TampaDeepSeaXplorersOpenSource/Dog-Breath/README.md

# Dog-Breath
High altitude canine respirator
