TampaDeepSeaXplorersOpenSource/Dog-Breath/Parts List for Dog Respirator.odt

Parts List for Dog Respirator

1 x SurgiVet free flow respirator cup

2 x PVC, T coupling, ½” x ¾ “

2 x 1” PVC, end cap, slip fitting

2 x PVC female reducer, ¾” x ½”, npt threaded

1 x PVC male reducer, ¾” x ½”, npt threaded

1 x PVC end cap, ½”, npt threaded

3 x PVC, ¾” sch 40, 2” length

6 x stainless steel washer, 3/16” x 1”

4 x stainless steel washer, #8 x ¼”

4 x stainless steel screw, #8 x 32, 2” length

4 x stainless steel screw, #8 x 32, ¾” length

8 x stainless steel lock nut, #8 x 32

8 x stainless steel nut, #8 x 32

2 x stainless steel spring, 3/8” x ¾”

2 x steel loop bracket, 1”

2 x rubber O ring, #8 x ¼”

1 x rubber O ring, 1/8” x 4 ¼”

2 x plastic gears, 1” dia.

1 x natural rubber sheet, 1/16” thick

1 x 3D printed adapter, 4 ¼” x 1”

1 x nylon web strap w/Velcro

Silicone grease

Smooth-On Rebound 25 Silicone rubber molding compound

Smooth-On XTC-3D, brush on coating for 3D printed parts

Epoxy

PVC cement
