TampaDeepSeaXplorersOpenSource/Dog-Breath/Regulator Case v1.stl

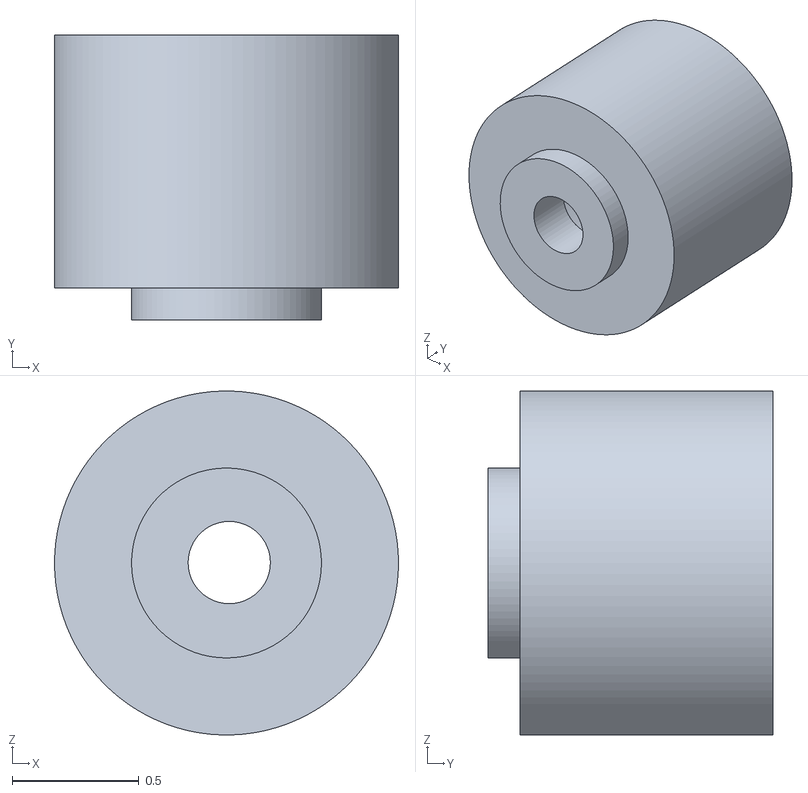
[picture p1: CAD file, 2017-06-01]
Regulator Case v1.stl
1.36 x 1.12 x 1.36
