TampaDeepSeaXplorersOpenSource/Dog-Breath/Regulator Cap v1.stl

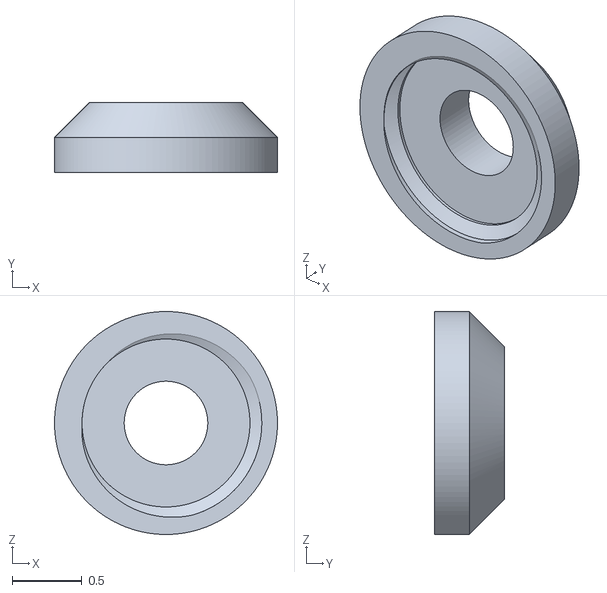
[picture p2: CAD file, 2017-06-01]
Regulator Cap v1.stl
1.60 x 0.5 x 1.60
