TampaDeepSeaXplorersOpenSource/Dog-Breath/Regulator seals.dxf

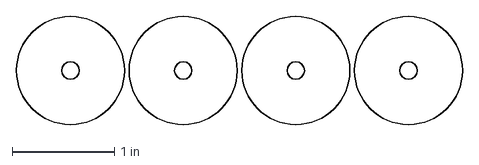
[picture p3: CAD file, 2017-06-01]
Regulator seals.dxf
4.35 x 1.06 in
