TampaDeepSeaXplorersOpenSource/Dog-Breath/Dog Respirator Adaptor v1.stl

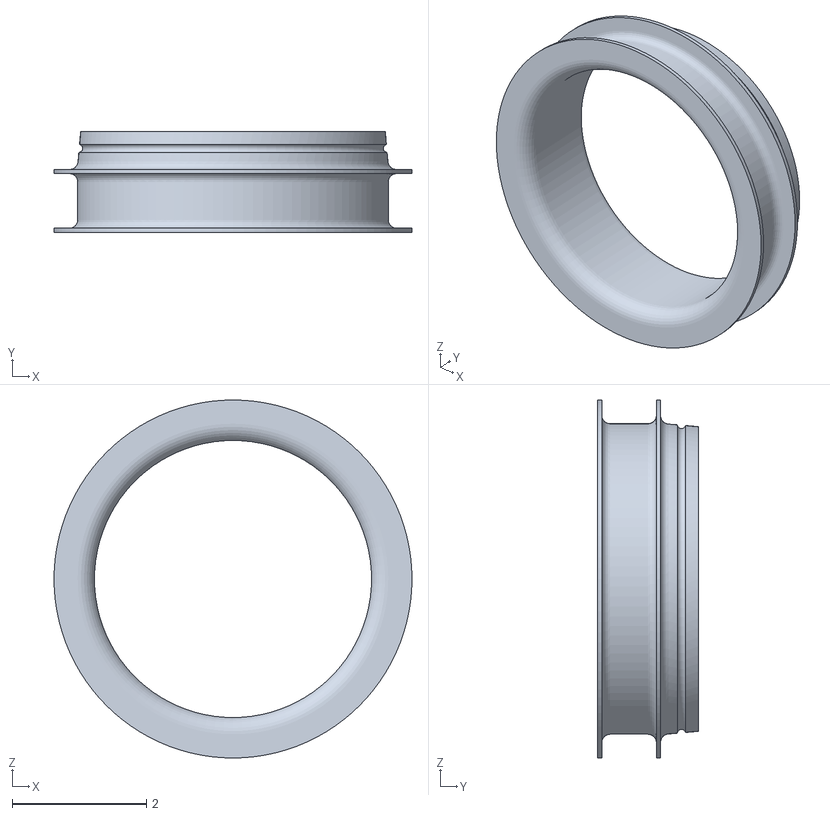
[picture p4: CAD file, 2017-06-01]
Dog Respirator Adaptor v1.stl
5.33 x 1.50 x 5.33
