TampaDeepSeaXplorersOpenSource/Dog-Breath/Regulator Piston v1.stl

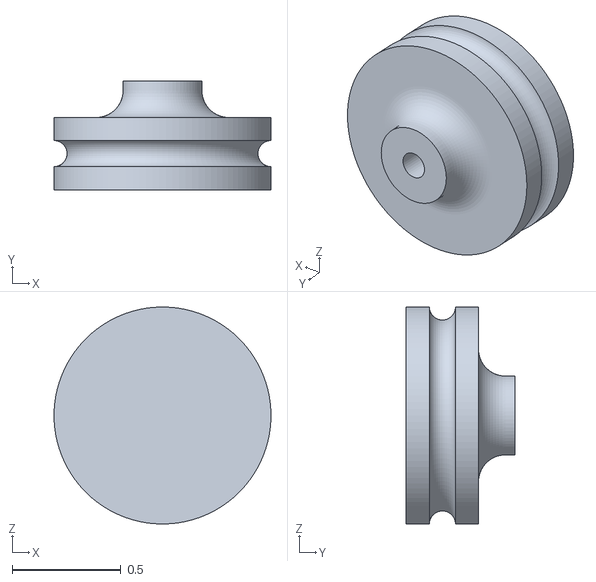
[picture p5: CAD file, 2017-06-01]
Regulator Piston v1.stl
1.00 x 0.5 x 1
