TampaDeepSeaXplorersOpenSource/Dog-Breath/How to build a demand regulator for under 10 dollars from common hardware.odt

How to build a demand regulator for less than 10 dollars from common hardware

Edward Larson

Parts needed:

1 x PVC, T coupling, ½” x ¾ “

1 x 1” PVC, end cap, slip fitting

1 x PVC female reducer, ¾” x ½”, npt threaded

1 x PVC, ¾” sch 40, 2” length

3 x stainless steel washer, 3/16” x 1”

2 x stainless steel machine screw, pan head, #8 x 32, 2” length

2 x stainless steel lock nut, #8 x 32

1 x stainless steel spring, 3/8” x ¾”

1 x rubber O ring, #8 x ¼”

1 x plastic gears, 1” dia.

1 x natural rubber sheet, 1/16” thick

PVC cement

Epoxy glue

Silicone grease

Tools needed:

1 Phillips head screw driver

X-acto knife

Process:

Start with the ½” x ¾” T

Place one of the 3/16” x 1” washers into the T. Notice that it is stopped by a ridge line inside of the T fitting. Glue the washer into place against the ridge line using epoxy. Be careful not to get epoxy on the center hole of the washer. Allow the epoxy to cure and then apply more epoxy to the joint between the T and the washer to make an air tight bead.

Cut a 1 1/16” diameter disc from the rubber sheet. Note that this is slightly larger than the diameter of the stainless steel washers. Sandwich the rubber disc between 2 of the 1” diameter washers. Cut a center hole in the disc using an X-acto knife. The hole needs to be large enough to pass a #8 machine screw through the hole.

Coat the disc with silicone grease. Be sure that the disc is completely coated but do not leave excess grease on the disc. There should be a thin film of silicone grease over the whole disc but there should not be any clumps of grease.

Sandwich the disc between 2 of the 1” diameter washers. Pass one of the 2” machine screws through the center hole of the washer and disc sandwich. Apply one of the lock nuts to the screw and tighten until it contacts the washer. Tighten the nut until it firmly holds the sandwich together but not enough to cause the rubber to expand around the edges. We will adjust the tightness in the next step. You have made the piston for the demand regulator.

Take the T that you glued the washer into. Take note of the side of the T that you glued the washer into and apply a little silicone grease to the inside of the T on the opposite side of the washer. Pass the piston assembly from the previous step into the end of the T with the grease, inserting the screw threads first into the T. Carefully pass the screw through the center hole of the washer inside of the T. You should be able to push the piston down into the T about half an inch. If you can’t then you have too much rubber extruding from edges of the piston. Remove the piston and make adjustments until the piston can be pushed down into the T about half an inch with only a little resistance.

Apply a little silicone grease to the #8 x ¼” O ring and to the surface of the washer that is inside of the T. Push the piston all the way into the T and put the O ring on the end of the screw. Push the O ring down about ¼” and then secure it with a locking nut. Tighten the nut until the shaft of the screw is flush with the top of the nylon locking material. Push the O ring and nut down until it is tight against the washer. You now have the main body of the regulator with the piston and valve assembly in place. This is the working part of the regulator.

Take the 1” PVC end cap. Drill a 1/8” hole in the end of the cap. Be very careful to insure that you drill the hole in the center of the cap. Tap the hole for a #8 x 32 machine screw. Put a 1” washer onto a 2” long #8 x 32 machine screw and secure it with a #8 x 32 nut. Tighten the nut until the washer is secured against the pan head of the screw. Place the threaded end of the screw into the open end of the end cap. Carefully thread the end of the screw into the end cap that you tapped for a #8 x 32 inch screw. Thread the screw all the way into the end cap. Apply a #8 x 32 nut to the end of the screw and tighten until ¼” of the threaded shaft protrudes above the nut. Drill and tap the plastic gear for a #8 x 32 machine screw. Screw the gear onto the end of the screw shaft protruding from the end cap. Secure the gear in place using a #8 x 32 lock nut. This is an adjustment screw assembly.

Place the adjustment screw assembly from the previous step over the end of the regulator body assembly on the side that has the piston. The adjustment screw assembly should fit snuggly over the regulator body. If it is too loose, build up the diameter of the regulator body using vinyl tape until it fits tight. Remove the adjustment screw assembly and place the stainless steel spring inside and reassemble. Now you can adjust the sensitivity of the regulator by tightening or loosening by turning the gear to tighten the screw.

Test your regulator by blowing and sucking air into and out of the 1/2” opening. The valve should open and allow air to flow into the regulator when you apply suction and the valve should close when you blow air into it. If your regulator works properly then you are ready to adapt the regulator to your air source.
